joaopedropio/volume-keeb/case/view/enc-metal.stl

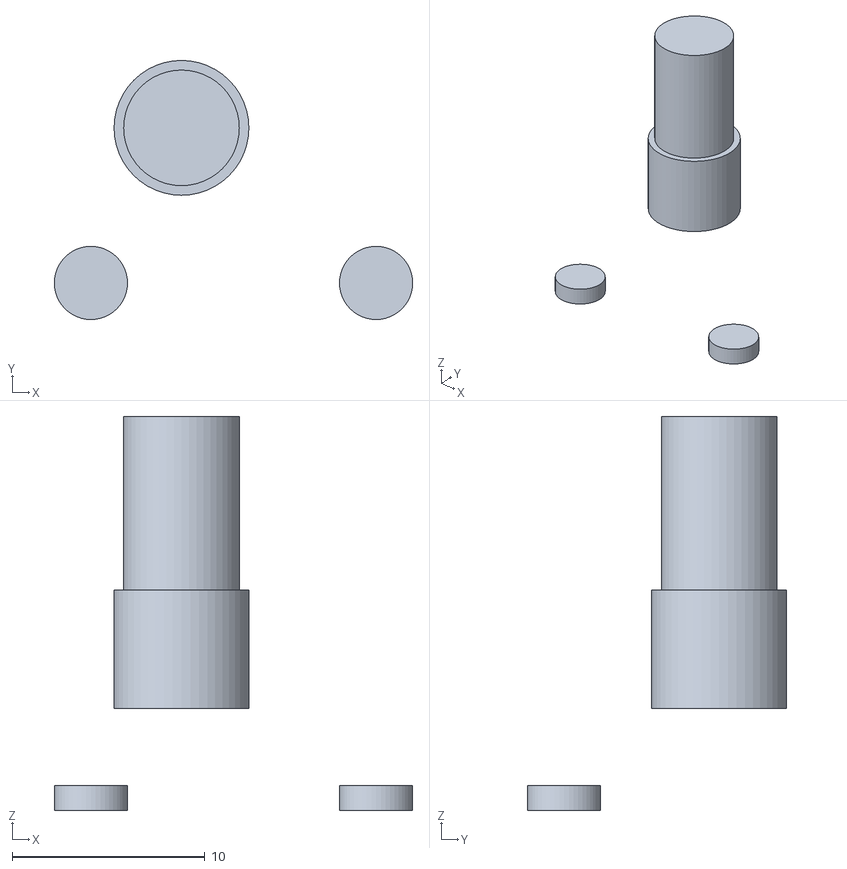
[picture p1: CAD file, 2026-10-20]
case/view/enc-metal.stl
18.6 x 13.5 x 20.4
