joaopedropio/volume-keeb/case/volume_case-base.stl

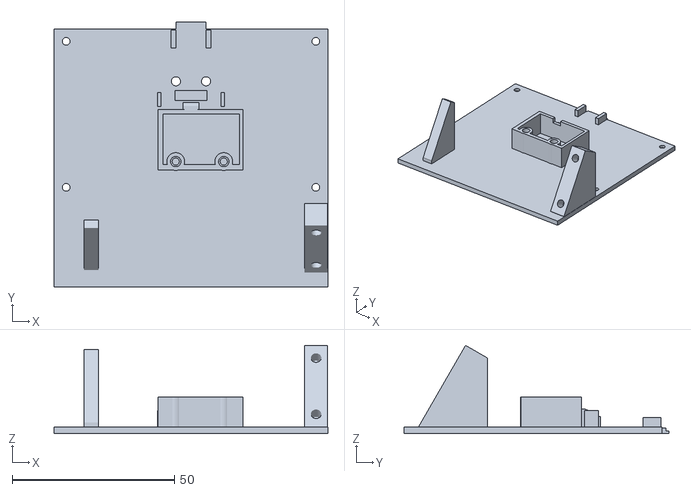
[picture p2: CAD file, 2026-10-20]
case/volume_case-base.stl
84.4 x 81.8 x 27.2
