joaopedropio/volume-keeb/case/view/zero-buttons.stl

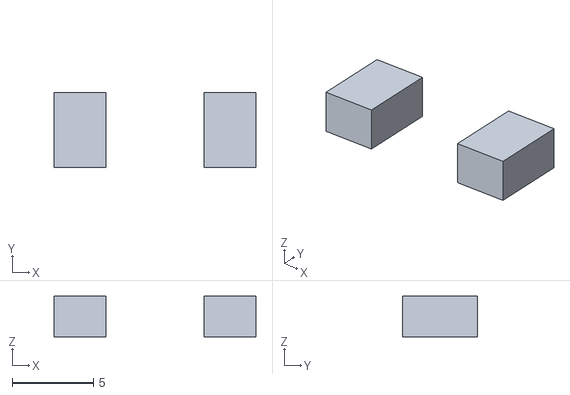
[picture p3: CAD file, 2026-10-20]
case/view/zero-buttons.stl
12.5 x 4.60 x 2.50
