joaopedropio/volume-keeb/case/volume_case-top.stl

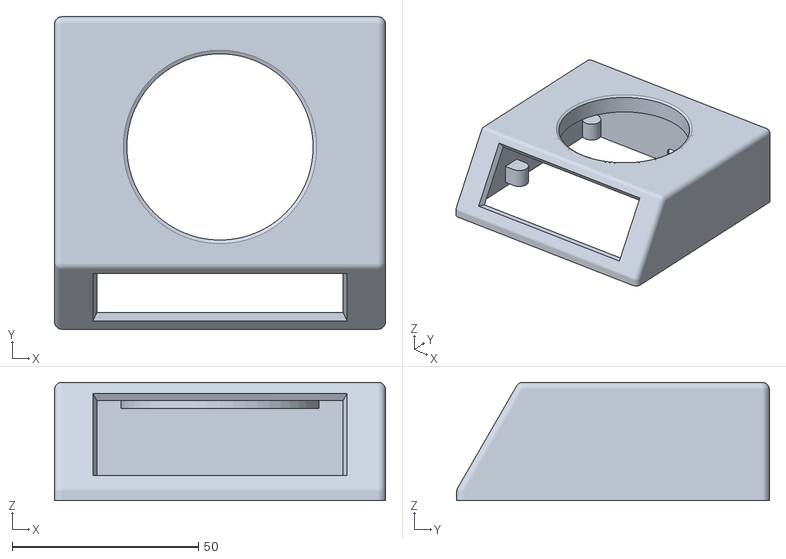
[picture p4: CAD file, 2026-10-20]
case/volume_case-top.stl
88.9 x 84.0 x 31.8
