joaopedropio/volume-keeb/case/view/screen-metal.stl

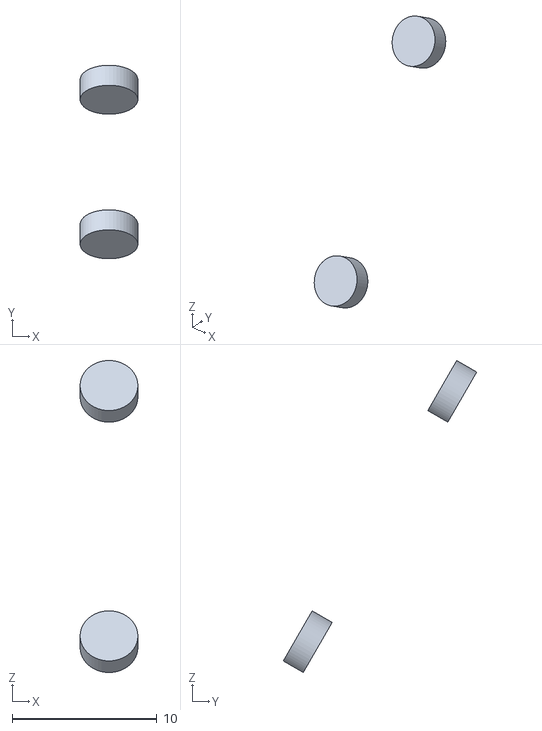
[picture p5: CAD file, 2026-10-20]
case/view/screen-metal.stl
4.00 x 13.4 x 21.6
