joaopedropio/volume-keeb/case/view/screen-pcb.stl

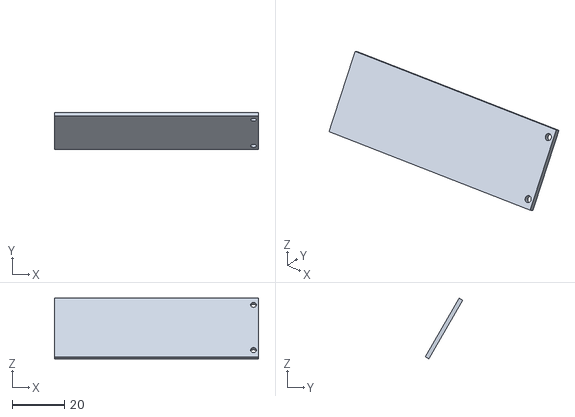
[picture p6: CAD file, 2026-10-20]
case/view/screen-pcb.stl
78.0 x 14.3 x 23.2
