joaopedropio/volume-keeb/case/view/zero-parts.stl

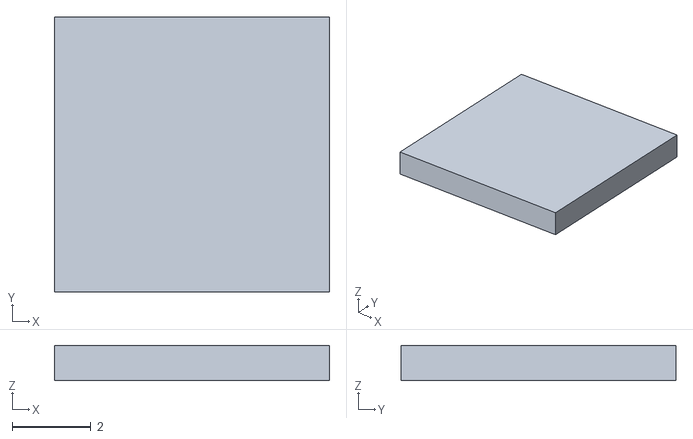
[picture p7: CAD file, 2026-10-20]
case/view/zero-parts.stl
7.00 x 7.00 x 0.9
