joaopedropio/volume-keeb/case/view/screen-parts.stl

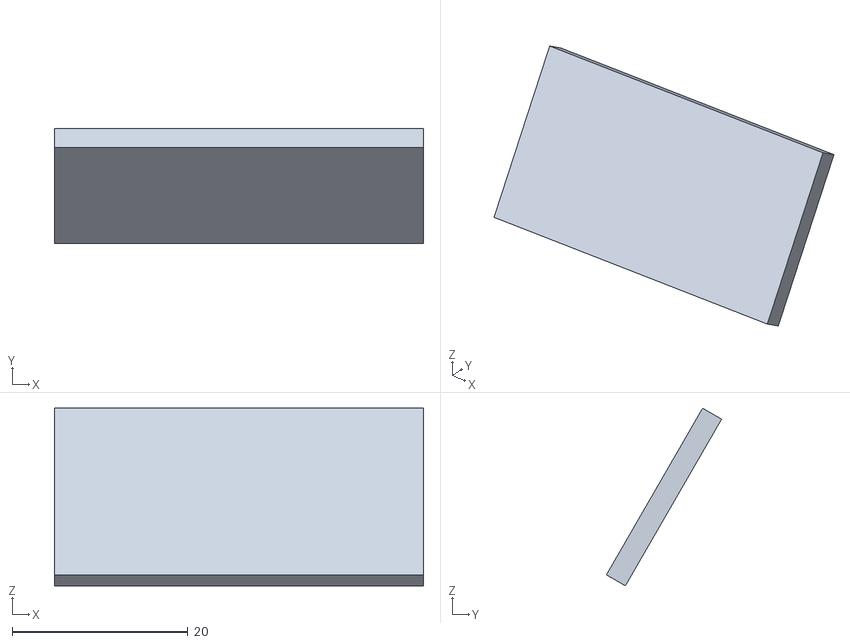
[picture p8: CAD file, 2026-10-20]
case/view/screen-parts.stl
42.0 x 13.1 x 20.2
