joaopedropio/volume-keeb/case/view/zero-usb.stl

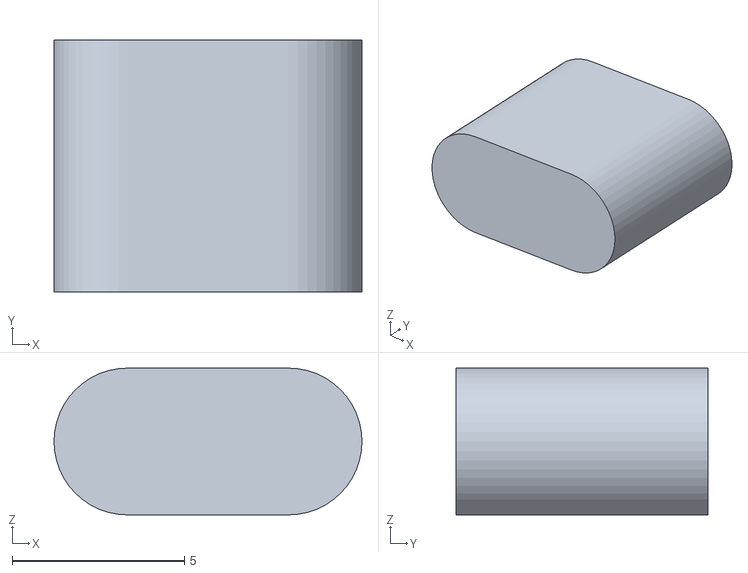
[picture p9: CAD file, 2026-10-20]
case/view/zero-usb.stl
8.94 x 7.32 x 4.26
