joaopedropio/volume-keeb/case/view/enc-body.stl

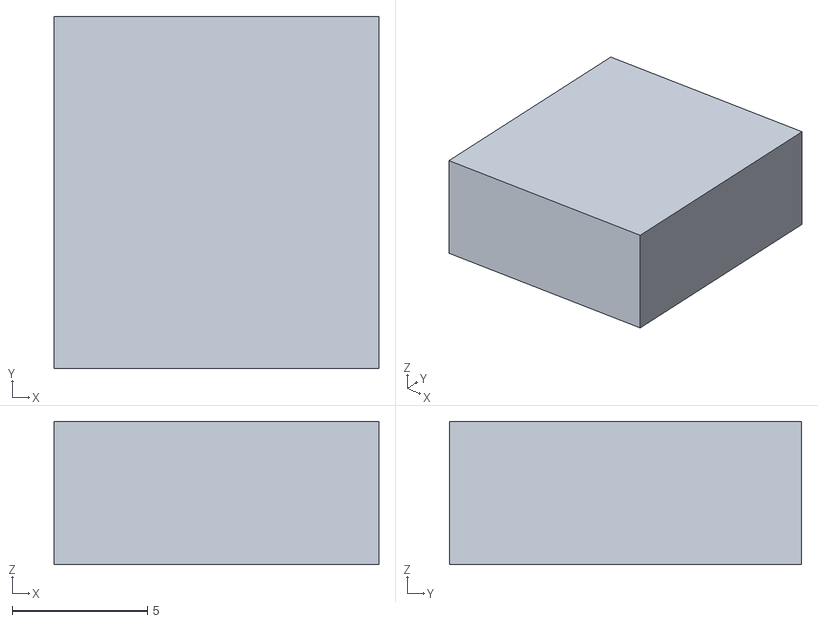
[picture p10: CAD file, 2026-10-20]
case/view/enc-body.stl
12.0 x 13.0 x 5.29
