joaopedropio/volume-keeb/case/view/screen-glass.stl

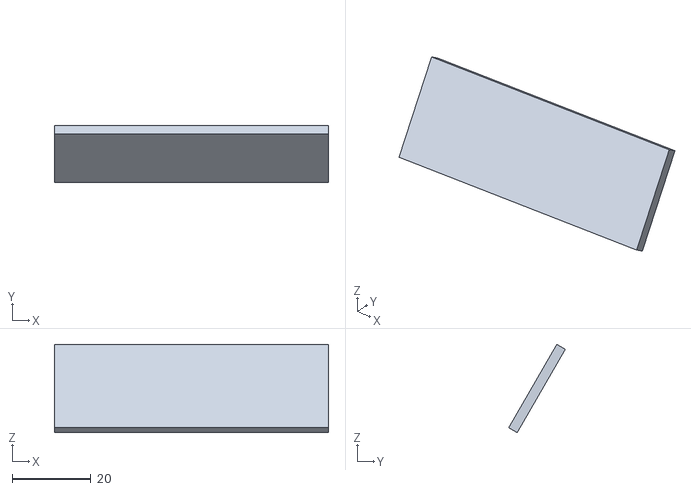
[picture p11: CAD file, 2026-10-20]
case/view/screen-glass.stl
69.4 x 14.4 x 22.4
