joaopedropio/volume-keeb/case/view/zero-pcb.stl

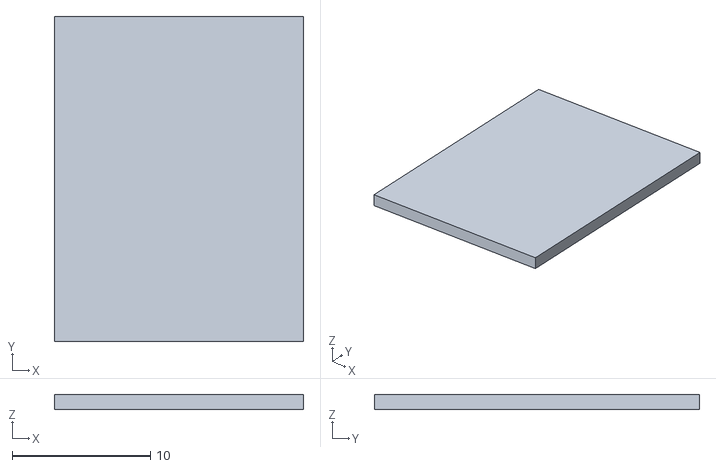
[picture p12: CAD file, 2026-10-20]
case/view/zero-pcb.stl
18.0 x 23.5 x 1.10
