joaopedropio/volume-keeb/case/view/knob.stl

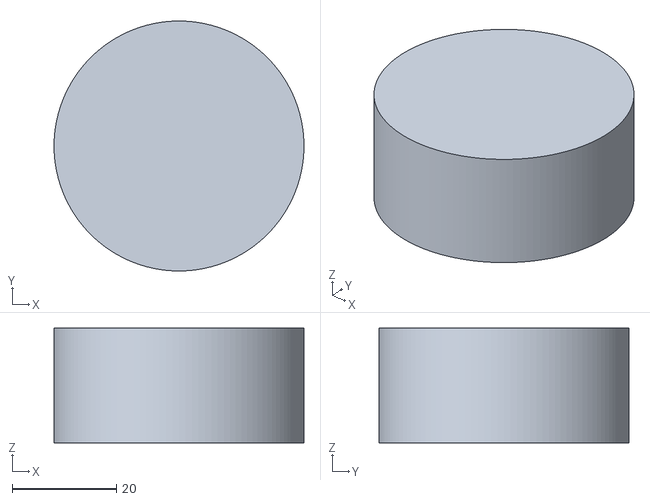
[picture p13: CAD file, 2026-10-20]
case/view/knob.stl
48.0 x 48.0 x 22.0
