joaopedropio/volume-keeb/case/view/enc-pcb.stl

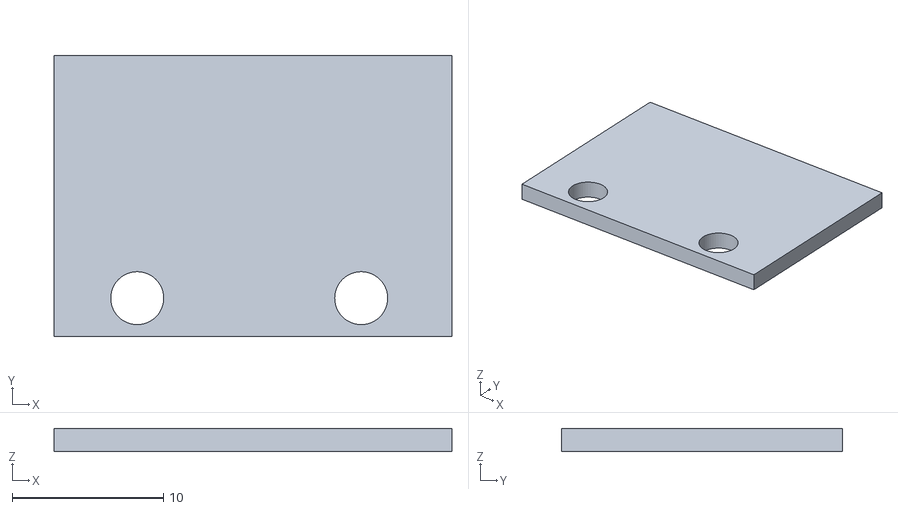
[picture p14: CAD file, 2026-10-20]
case/view/enc-pcb.stl
26.3 x 18.6 x 1.55
