joaopedropio/volume-keeb/(commit log)

2026-08-24 Initial commit: HW-040 volume-knob QMK firmware on RP2040-Zero
    Split out of single-keeyb into its own project. The encoder's SW pin
    is wired as the sole 1x1 matrix key (mapped to mute); CLK/DT are
    declared separately under keyboard.json's encoder.rotary and drive
    QMK's default volume up/down behavior on rotation.
    Claude-Session: https://claude.ai/code/session_012ps9peTfNBiELQboS8ZVSR
2026-09-22 Add OLED display showing volume and Chrome's playing title
    Drive a 1.3" GME12864 OLED (SH1107, 64x128 rotated to landscape) on I2C0
    (GP4/GP5). The display shows the title of whatever Chrome is playing in 2x
    text, centered or scrolling when it doesn't fit, above a volume bar with the
    percentage to its right.
    The keyboard can't read host state, so host/volume_sync.py (stdlib only)
    pushes the pactl volume/mute and Chrome's MPRIS title over QMK Raw HID.
    Includes a udev rule for hidraw access and a systemd user unit.
    [config.h]
2026-09-23 Swap OLED for a 76x284 ST7789 SPI screen with a two-screen app mixer
    Replaces the single-master-volume OLED display with a Quantum Painter
    driven ST7789 LCD and a menu/app-picker UI: a menu screen lists every
    PulseAudio/PipeWire stream plus Master, and an app screen shows the
    selected app's name, media title, and volume. Scroll changes selection
    or volume depending on screen; click opens an app or goes back to the
    menu; double-click pauses; click-and-hold mutes.
    host/volume_sync.py now enumerates per-app streams and MPRIS players
    instead of just the default sink and Chrome, and both reads and writes
    the knob's Raw HID node so it can apply the volume/mute/play-pause
    actions the firmware send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
    [config.h]
2026-09-23 Drive the ST7789 landscape instead of portrait
    Rotates the panel 90 degrees (QP_ROTATION_90) so the UI runs at its
    native landscape aspect, 284x76 instead of 76x284. Reworks both
    screens for the short, wide canvas: the menu becomes a horizontally-
    scrolling row of app chips instead of a vertical list, and the app
    screen's name/title/percentage/bar move from stacked rows into a
    layout that uses the extra width (dropping the on-screen hold/double-
    click hint text, since there's no vertical room left for it).
    Also regenerates graphics/*.qff.c without anti-aliasing (--no-aa) —
    crisper on a 1-bit mono display, and it removes the AA-to-mono2
    thresholding step as a source of drift between the in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
    [config.h]
2026-09-23 Restyle the app/menu screens after a green-terminal reference design
    The user pointed at a Figma Make prototype ("Volume Controller UI")
    with a retro green-phosphor terminal look, and asked for something
    similar. Reworks both screens' visuals to match: HSV_GREEN (pure
    green) replaces HSV_SPRINGGREEN/HSV_WHITE as the primary color, with
    a new dim-green (HSV_DIMGREEN) for secondary text and unlit bar
    segments; the app screen's centered percentage becomes a "VOL nn" /
    "MUTE" pairing in a thin header row next to the app name, the title
    gets promoted to the dominant big-font element, and the single-fill
    volume bar becomes a 20-segment VU-meter-style bar. The menu's chips
    gain a small marker for w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
2026-09-23 Add a neobrutalist theme and a --theme flag to pick it on the host
    Introduces a runtime theme system in keymap.c: a themes[] table of
    flat HSV palettes plus a `boxed` flag, selected by a new THEME_CMD
    (0x63) Raw HID packet. `terminal` (index 0) is the existing flat
    green-phosphor look, unchanged. `neobrutal` (index 1) is new: cream/
    near-black/orange with thick borders and hard, unblurred drop
    shadows on the header's VOL/MUTE badge, the volume bar's frame, and
    the menu chips — based on a neobrutalist reference image the user
    provided (cream/sage/dark player mockups with black borders and
    offset shadows).
    host/volume_sync.py gains `--theme {terminal,neobrutal}` (default
    terminal) as the wa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
2026-09-23 Add a Winamp-styled theme (bevels + LCD wells)
    Extends the theme system with a third decoration style, DECOR_BEVEL,
    alongside the existing flat (terminal) and boxed (neobrutal) styles:
    raised/sunken 1px bevel edges (a fixed dark edge, the theme's `fg` as
    the light edge) instead of a hard drop shadow. Also adds a `well`
    palette entry, the sunken "LCD readout" background distinct from the
    chassis `bg` chips/space sit on -- equal to `bg` for the two existing
    themes, so their rendering is unchanged.
    The new `winamp` theme (index 2) sinks the header, title and volume
    bar into black wells on a grey-blue chassis, with green readout text
    and an amber accent, after the classic Winamp player skin. Me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
2026-10-02 Move to new wiring and fix ST7789 bring-up on the 76x284 panel
    Encoder now on GP27/GP28/GP29 (CLK/DT/SW). Display on SPI0: SCK GP2,
    MOSI GP3, CS GP1, DC GP4, RST GP5, BL GP0; the unused MISO moves to
    GP16 (not broken out) so it doesn't collide with DC.
    Panel fixes found on hardware: viewport offsets (18, 82) because the
    glass is centered in the controller's 240x320 RAM, invert-off after
    init (QMK always sends INVON), and an active-low backlight, wrapped in
    LCD_BLK_ON()/LCD_BLK_OFF(). Also include color.h explicitly for the
    HSV_* macros on newer QMK.
    Adds diag (solid-color cycle) and usbonly (no display code) keymaps as
    bring-up tools.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
    [config.h]
2026-10-09 Swap to a 2.8" 240x320 ILI9341 display and rescale the layout
    [config.h]
2026-10-09 Support the 2.79" NV3007 142x428 panel with a custom Quantum Painter driver
2026-10-20 Make the NV3007 the default display: fix backlight polarity and update README
    The NV3007 module's backlight is active-high, so flip LCD_BLK_ON/OFF.
    README: drop the experimental-branch note, fix the stale 76px/20-segment
    figures, and document the custom NV3007 driver and its config.h knobs.
    [config.h]
2026-10-20 Add a 3D-printed case for the NV3007 screen, the 48 mm knob and the RP2040-Zero
    case/volume_case.scad (OpenSCAD, parametric) draws a two-piece box after the
    MaxMix: the NV3007 behind a window in a 60° front face, the knob sunk 7 mm
    into a plain hole in the flat top, USB-C centred in the back. Every part is
    held by the base (screen on ribs, encoder on a four-wall frame, RP2040-Zero
    upside down with BOOT/RESET pressed through holes in the bottom), so the top
    lifts straight off; all screws go into M2 heat-set inserts.
    Only the HW-040 is measured; encoder = "ky040" fails an assert until its
    numbers are in. case/gen_case.sh exports the STLs and the pieces for
    case/viewer.html (a WebGL view with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
    [enc-body.stl, enc-metal.stl, enc-pcb.stl, knob.stl, screen-glass.stl, screen-metal.stl, screen-parts.stl, screen-pcb.stl]
2026-10-20 Publish the case's 3D view on GitHub Pages
    case/viewer.html is a whole HTML document now, with a link to the STLs, and
    case/deploy_pages.sh copies it and the STLs it loads into the
    joaopedropio.github.io checkout under volume-keeb/. README links the live page.
2026-10-20 Turn the README into a build guide, move the internals to docs/DEVELOPMENT.md
    The README now walks someone through building their own knob: parts,
    tools, printing and inserts, firmware build and flash, wiring, testing,
    assembly, host setup, usage, themes and troubleshooting. The driver,
    protocol, tuning constants and case internals go to docs/DEVELOPMENT.md.
2026-10-30 List the screen's wires in the order of its pads
2026-10-30 Draw the wiring as a picture, each part seen from the side it's soldered on
    docs/gen_wiring.py (adapted from dongle-slayer's tools/gen_wiring.py) writes
    docs/wiring.svg to scale from the case's numbers; it replaces the README's
    text diagram.
2026-10-30 App list menu, title ticker, neon theme, flicker-free drawing, flash.sh
    - Menu is a vertical list, one app per row followed by its song title.
    - The app screen's title enters at the right edge and scrolls left,
    pixel by pixel, clipped at the edges through an off-screen surface.
    - Draw into a full-screen framebuffer and send only the changed
    rectangle to the panel, so redraws no longer flash the screen.
    - New default theme, neon: deep violet, cyan text, hot-pink glowing
    outlines and a gradient volume bar.
    - Blank after 30 s by painting black and dropping the backlight, and
    disable Quantum Painter's own 30 s timeout, whose DISPOFF turned the
    lit panel white and faded it out.
    - LCD_OF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
    [config.h]
2026-10-31 Settings page with a tray icon, custom colors and fonts, Windows host, synthwave screensaver
    The host daemon becomes an app (host/volume_keeb/) that runs in the
    background on Linux and Windows and serves a settings page on
    localhost:8137, opened from a tray icon: preset themes, any of the six
    colors, the decor style, and a font of your own for each text slot.
    Firmware: PALETTE_CMD sets the whole palette; FONT_* commands upload a
    QFF font into one of three flash slots (font_store.c) that survive
    reboots and reflashing; the title ticker handles proportional fonts.
    The host converts TTF/OTF to QFF itself (qff.py), no QMK CLI needed.
    Windows: WASAPI sessions (pycaw), media sessions (pywinrt),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
    [config.h]
2026-10-31 Prebuilt releases: firmware and Windows app from GitHub Actions
    A v* tag builds volume-keeb.uf2 (QMK's qmk_cli container, qmk_firmware
    pinned to 0.34.4) and volume-keeb.exe (build_windows.ps1 on a Windows
    runner) and publishes them with the case STLs as a GitHub release.
    The README now has people download those instead of installing QMK and
    a toolchain; building from source moves to docs/DEVELOPMENT.md, along
    with building the .exe and cutting a release. flash.sh can flash a given
    .uf2, so a downloaded update needs no buttons either. Also stops calling
    the host app a daemon in the README.
2026-10-31 More screensavers, chosen on the settings page, and a screen-off timer
    Four new screensavers next to the synthwave drive, all in the theme's
    colors: stars (a flight through a star field), rain (Matrix-style
    glyphs), plasma and bounce (what's playing, bouncing off the edges).
    The settings page's new Screen section picks one (or none), how long
    the knob sits untouched before it starts, and whether the backlight
    turns off after a while; "Show on the knob" starts it right away. The
    host sends this with the new SCREEN_CMD (0x6B) on every connect, like
    the palette. Waking the computer now brings the UI back and restarts
    the idle timers.
2026-10-31 Loading screen at boot, and the knob's own settings without the host app
    At boot the knob shows "waiting for the computer" with a bar filling
    for up to 5 s, instead of "no apps". With no host app by then, or once
    it goes away, the menu becomes a settings list headed "NO APP ON THIS
    COMPUTER": theme (the presets), screensaver, its idle time, the
    screen-off time and a preview, changed with a click and a turn.
    Those settings now live in EEPROM (QMK's user datablock), saved
    whenever the host or the knob changes them, so the knob keeps its look
    and its screensaver and screen-off timers on a computer without the
    app. A host that connects sends its own, which win.
    The list rows' drawing is shared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
2026-10-31 Drive screensaver: a neon city at night, and a route with straights
    The drive loses its sun and mountains for a starry violet sky over a
    neon city (towers[]: striped, columned, windowed and sign towers with
    antennas, roof frames and lights, a hazy skyline behind). The road is
    dark violet with cyan/magenta kerbs and short dashes, the sea's bricks
    are in the city's colors, the palms neon green and yellow, placed
    unevenly and re-picked each time round, and the car is a wide cyan
    sports car with an orange tail-light band and spinning tyres. The
    horizon sits lower, giving the sky more room.
    Instead of swaying all the time, the car follows a route of 5 s
    straights and 4 s turns (drive_route()), a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
2026-10-31 Three themes with their own App screen: studio, hifi and console
    studio puts the volume on a dial (a ring of dots around a knob face),
    hifi on an analog VU meter, console on a fader with an LED column; all
    three show the name, title, play state and hints in a panel beside it,
    and their menu rows carry each app's volume. The settings page previews
    them, and the simulator also renders a muted app and one without media.
2026-10-31 GIF screensavers: three flash slots the GIF page sends animations to
    The GIF page moves into the host app (/gif) and gets a Send to the knob
    step: it encodes the cropped art pixels as a KVA1 animation (RGB565
    palette, runs that skip what the previous frame already drew) and
    uploads it into one of three 256 kB store slots after the fonts. The
    firmware checks the whole file when the upload ends and plays it as the
    gif1-gif3 screensavers, scaling each art pixel up and sending only the
    rows that changed. Empty slots show the drive; the knob's settings skip
    them.
    [config.h]
2026-10-31 GIF page: still images too, and merging similar shades
    PNG, JPEG and WebP already loaded as one frame; the frame controls now
    hide for them and the size line says still. A Similar shades option
    (on by default) folds the near-duplicate colors JPEG and lossy GIFs
    leave around flat areas into the most common color near them, so a
    JPEG of pixel art comes back with its own palette.
2026-10-31 GIF page: rotate and mirror the image
    Quarter turns either way, 180 and a left-right mirror, applied to the
    decoded frames before the pixel grid is found, so a portrait image can
    be laid on the landscape screen.
2026-10-31 Remove mentions of dongle-slayer
    [volume_case.scad]
2026-10-31 VU meter: print it in fg when the face is as dark or light as bg
    The VU decor drew its scale, needle and the selected row's text in bg, on
    the well-colored face. With another preset's colors (neon, neobrutal,
    terminal...) the well equals bg and all of it vanished. vu_ink() picks
    fg instead when the two are within 96 of each other in brightness; the
    settings page's preview does the same, and ui_sim renders every preset's
    colors with the VU decor.
2026-11-02 Keep fonts and gifs on the knob, Windows installer, code signing prep
    Fonts and gifs: a host that didn't know the knob's slots cleared them
    (plugging the knob into a new computer wiped its gifs). The knob's copy
    now wins: new STORE_READ_CMD (0x6E) / STORE_DATA_CMD (0x75) let the host
    read a slot back, and sync_store() takes a slot that differs into the
    config (or drops it if empty on the knob). Only slots changed while the
    knob was away (config "pending") go to the knob. Fonts read back have
    only their QFF; qff.decode()/preview_qff() preview them. With firmware
    before v0.6.0 the host leaves the slots alone on both sides. The pages
    reload slots when they arrive (state's store_rev).
    Windows: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
2026-11-02 Power on straight into the screensaver
    The loading screen still runs behind it and the first touch shows
    whichever screen it got to. With no screensaver picked, nothing changes.
2026-11-02 Call it Volume Keeb wherever people read the name
    The knob's screens, the USB product string, the settings page, the tray,
    the installer and .exe metadata, the Linux menu entry and the docs.
    volume-keeb stays in identifiers (repo, URLs, release files, config
    folders, the Run value), so links and installs keep working; the
    installer removes the old volume-keeb shortcuts.
    [volume_case.scad]
2026-11-03 Six gif screensaver slots
    gif4-6 are new 256 kB slots between the firmware and the fonts (0x30000
    up); gif1-3 and the fonts stay where they were, so updating keeps them.
    The firmware now gets the flash's first 192 kB (FIRMWARE_MAX), and the
    build fails if it outgrows that.
    Nine slots' CRCs don't fit one report: 0x6A takes the first slot to
    report and 0x72 carries at most 7, so the host asks again from 7 on
    firmware v0.7.0 and later. The pages only show the slots the knob has.
    [config.h]
2026-11-03 GIF page: make an animation smaller before sending it
    A "Make it smaller" block next to the size: cut the start or end, keep
    every Nth frame, click frames off in a strip that shows what each one
    takes (a dropped frame's time goes to the one before), pick fewer
    colors, or let "Make it fit" find a frame step and colors that fit the
    slot. The preview and the downloads follow the edits.
